PhamChinhCode/PID-G4-Master-Control/PID -Master-Control.kicad_pcb

## KiCad design PID -Master-Control.kicad_pcb (2026-11-12)

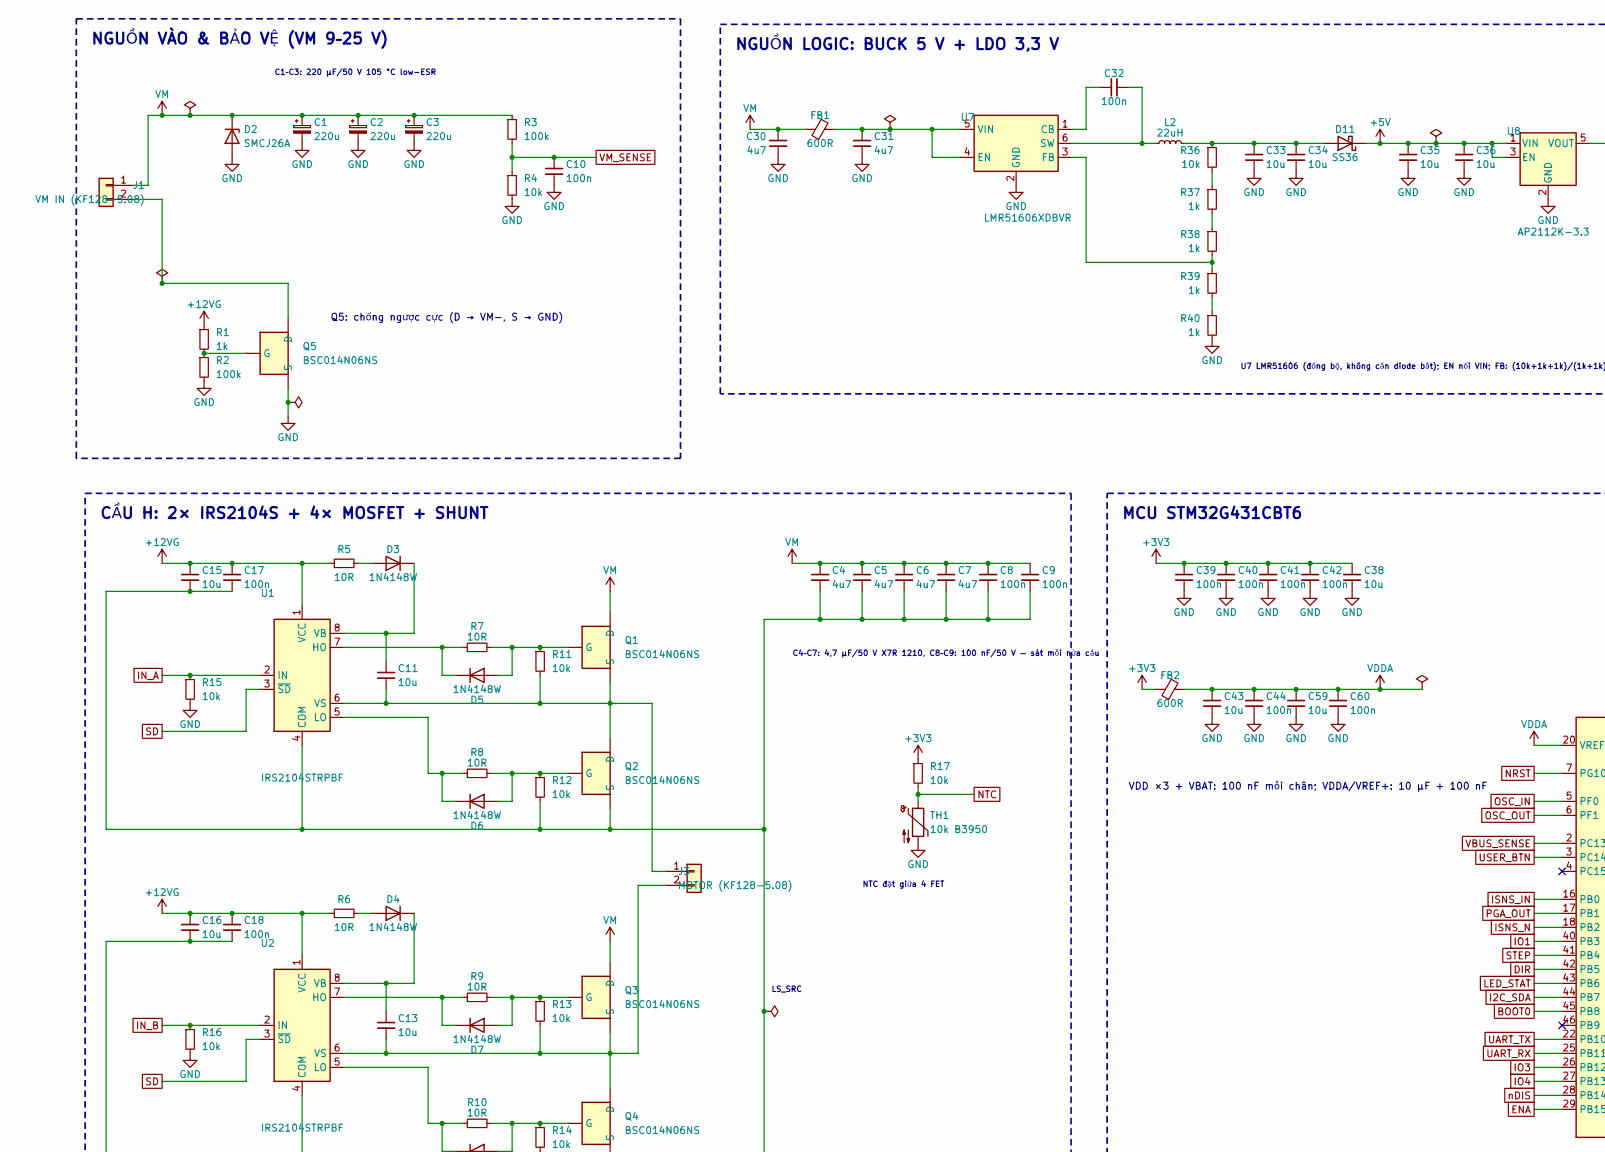
[picture p1: schematic PID -Master-Control.kicad_sch, G4_PID_Driver_V1, part in row 1, column 1]

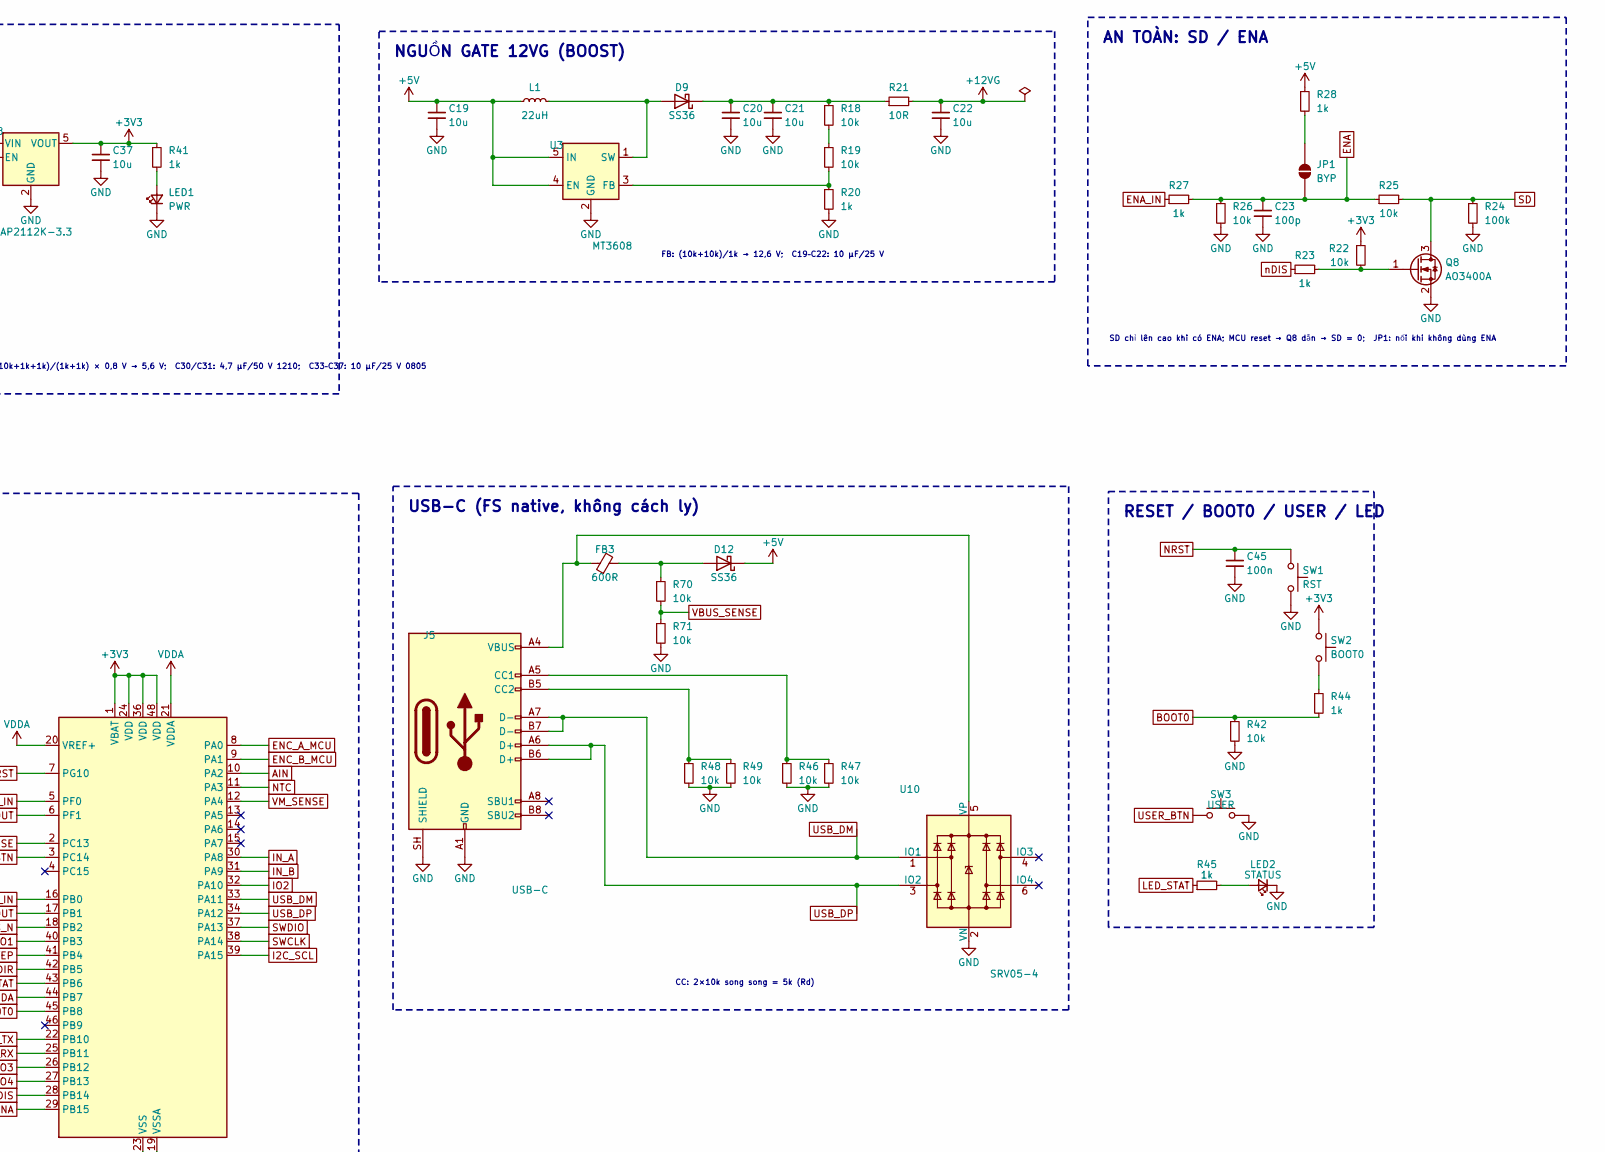
[picture p2: schematic PID -Master-Control.kicad_sch, G4_PID_Driver_V1, part in row 1, column 2]

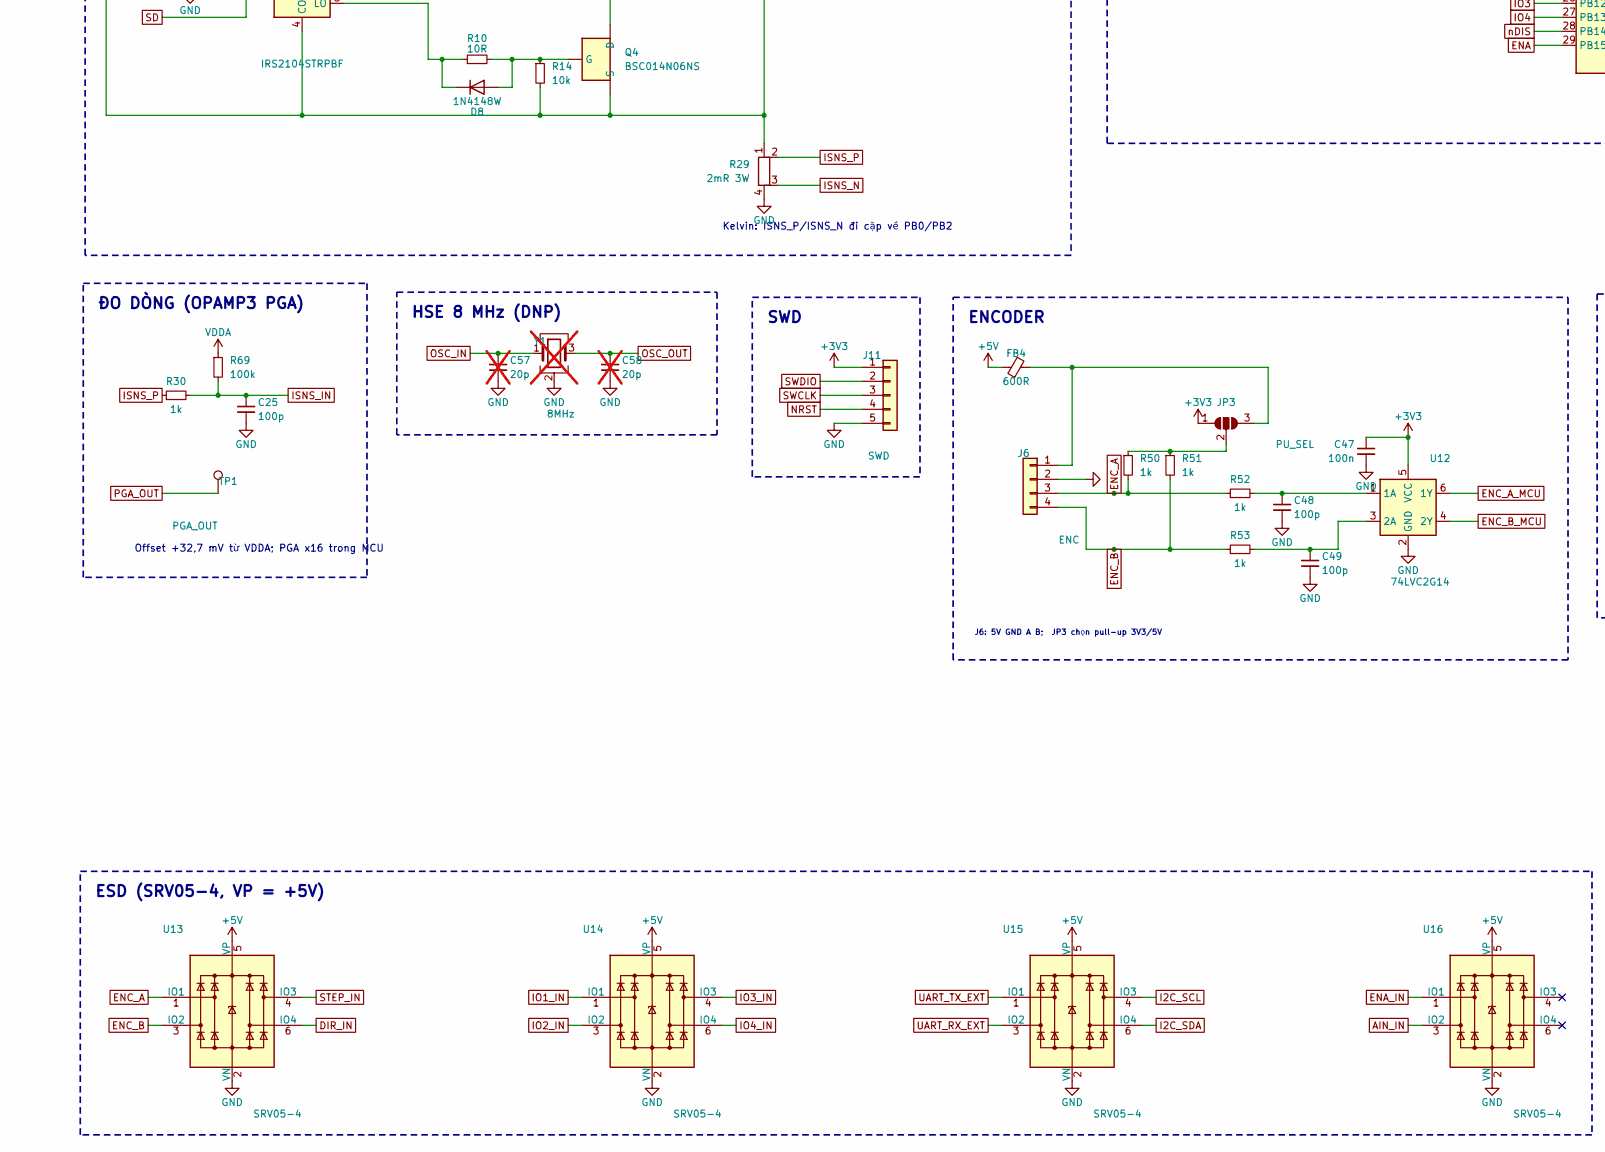
[picture p3: schematic PID -Master-Control.kicad_sch, G4_PID_Driver_V1, part in row 2, column 1]

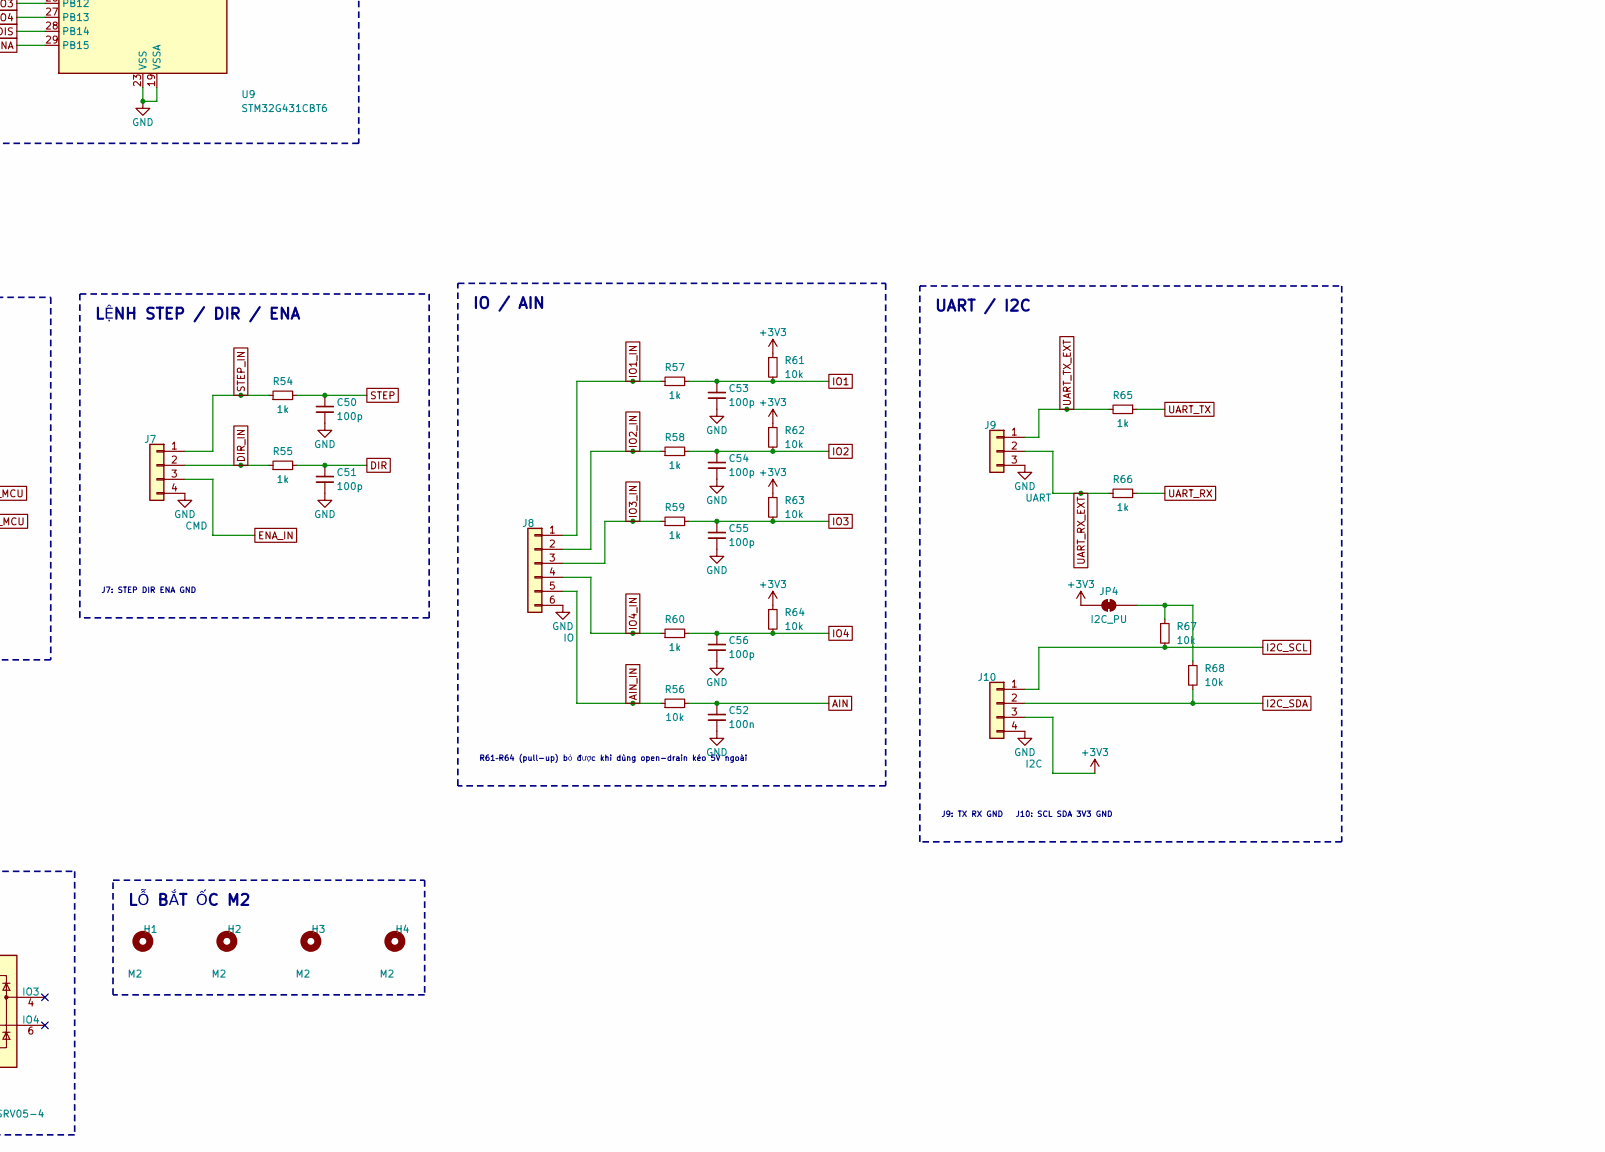
[picture p4: schematic PID -Master-Control.kicad_sch, G4_PID_Driver_V1, part in row 2, column 2]

Parts:
C1, C2, C3: 220u; CP_Elec_10x10.5
C4, C5, C6, C7, C30, C31: 4u7; C_1210_3225Metric
C8, C9, C10, C17, C18, C32, C39, C40, C41, C42, C44, C45, C47, C52, C60: 100n; C_0603_1608Metric
C11, C13, C15, C16, C19, C20, C21, C22, C33, C34, C35, C36, C37, C38, C43, C59: 10u; C_0805_2012Metric
C23, C25, C48, C49, C50, C51, C53, C54, C55, C56: 100p; C_0603_1608Metric
C57, C58: 20p; C_0603_1608Metric; not fitted
D2: SMCJ26A; D_SMC
D3, D4, D5, D6, D7, D8: 1N4148W; D_SOD-123
D9, D11, D12: SS36; D_SMA
FB1, FB2, FB3, FB4: 600R; L_0805_2012Metric
H1, H2, H3, H4: M2; MountingHole_2.2mm_M2
J1: VM IN (KF128-5.08); KF128-5.08-2P
J3: MOTOR (KF128-5.08); KF128-5.08-2P
J5: USB-C; USB_C_Receptacle_HRO_TYPE-C-31-M-12
J6: ENC; JST_XH_S4B-XH-A_1x04_P2.50mm_Horizontal
J7: CMD; JST_XH_S4B-XH-A_1x04_P2.50mm_Horizontal
J8: IO; JST_XH_S6B-XH-A_1x06_P2.50mm_Horizontal
J9: UART; JST_XH_S3B-XH-A_1x03_P2.50mm_Horizontal
J10: I2C; JST_XH_S4B-XH-A_1x04_P2.50mm_Horizontal
J11: SWD; JST_XH_S5B-XH-A_1x05_P2.50mm_Horizontal
JP1: BYP; SolderJumper-2_P1.3mm_Open_RoundedPad1.0x1.5mm
JP3: PU_SEL; SolderJumper-3_P1.3mm_Open_RoundedPad1.0x1.5mm_NumberLabels
JP4: I2C_PU; SolderJumper-2_P1.3mm_Bridged_RoundedPad1.0x1.5mm
L1, L2: 22uH; L_Bourns-SRN4018
LED1: PWR; LED_0603_1608Metric
LED2: STATUS; LED_0603_1608Metric
Q1, Q2, Q3, Q4, Q5: BSC014N06NS; TDSON-8-1
Q8: AO3400A; SOT-23
R1, R20, R23, R27, R28, R30, R37, R38, R39, R40, R41, R44, R45, R50, R51, R52, R53, R54, R55, R57, R58, R59, R60, R65, R66: 1k; R_0603_1608Metric
R2, R3, R24, R69: 100k; R_0603_1608Metric
R4, R11, R12, R13, R14, R15, R16, R17, R18, R19, R22, R25, R26, R36, R42, R46, R47, R48, R49, R56, R61, R62, R63, R64, R67, R68, R70, R71: 10k; R_0603_1608Metric
R5, R6, R7, R8, R9, R10, R21: 10R; R_0603_1608Metric
R29: 2mR 3W; R_Shunt_Vishay_WSK2512_6332Metric_T1.19mm
SW1: RST; SW_SPST_PTS810
SW2: BOOT0; SW_SPST_PTS810
SW3: USER; SW_SPST_PTS810
TH1: 10k B3950; R_0603_1608Metric
TP1: PGA_OUT; TestPoint_Pad_D1.5mm
U1, U2: IRS2104STRPBF; SOIC-8_3.9x4.9mm_P1.27mm
U3: MT3608; SOT-23-6
U7: LMR51606XDBVR; SOT-23-6
U8: AP2112K-3.3; SOT-23-5
U9: STM32G431CBT6; LQFP-48_7x7mm_P0.5mm
U10, U13, U14, U15, U16: SRV05-4; SOT-23-6
U12: 74LVC2G14; SOT-23-6
Y1: 8MHz; Crystal_SMD_3225-4Pin_3.2x2.5mm; not fitted

Connections:
+3V3: C37.1, C38.1, C39.1, C40.1, C41.1, C42.1, C47.1, FB2.1, J10.3, J11.1, JP3.1 (A), JP4.1 (A), R17.1, R22.1, R41.1, R61.1, R62.1, R63.1, R64.1, SW2.1, U8.5 (VOUT), U9.1 (VBAT), U9.24 (VDD), U9.36 (VDD), U9.48 (VDD), U12.5 (VCC)
+5V: C19.1, C35.1, C36.1, D11.1 (K), D12.1 (K), FB4.1, L1.1, R28.1, U3.4 (EN), U3.5 (IN), U8.1 (VIN), U8.3 (EN), U13.5 (VP), U14.5 (VP), U15.5 (VP), U16.5 (VP)
+12VG: C15.1, C16.1, C17.1, C18.1, C22.1, R1.1, R5.1, R6.1, R21.2, U1.1 (VCC), U2.1 (VCC)
AIN: C52.1, R56.2, U9.10 (PA2)
AIN_IN: J8.5, R56.1, U16.3 (IO2)
BOOT0: R42.1, R44.2, U9.45 (PB8)
DIR: C51.1, R55.2, U9.42 (PB5)
DIR_IN: J7.2, R55.1, U13.6 (IO4)
ENA: C23.1, JP1.2 (B), R25.1, R26.1, R27.2, U9.29 (PB15)
ENA_IN: J7.3, R27.1, U16.1 (IO1)
ENC_A: J6.3, R50.2, R52.1, U13.1 (IO1)
ENC_A_MCU: U9.8 (PA0), U12.6 (1Y)
ENC_B: J6.4, R51.2, R53.1, U13.3 (IO2)
ENC_B_MCU: U9.9 (PA1), U12.4 (2Y)
GND: C1.2, C2.2, C3.2, C10.2, C19.2, C20.2, C21.2, C22.2, C23.2, C25.2, C30.2, C31.2, C33.2, C34.2, C35.2, C36.2, C37.2, C38.2, C39.2, C40.2, C41.2, C42.2, C43.2, C44.2, C45.2, C47.2, C48.2, C49.2, C50.2, C51.2, C52.2, C53.2, C54.2, C55.2, C56.2, C57.2, C58.2, C59.2, C60.2, D2.2 (A), J5.A1 (GND), J5.A12 (GND), J5.B1 (GND), J5.B12 (GND), J5.SH (SHIELD), J6.2, J7.4, J8.6, J9.3, J10.4, J11.5, LED1.1 (K), LED2.1 (K), Q5.1 (S), Q5.2 (S), Q5.3 (S), Q8.2 (S), R2.2, R4.2, R15.2, R16.2, R20.2, R24.2, R26.2, R29.4, R40.2, R42.2, R46.2, R47.2, R48.2, R49.2, R71.2, SW1.2, SW3.2, TH1.2, U3.2 (GND), U7.2 (GND), U8.2 (GND), U9.19 (VSSA), U9.23 (VSS), U9.35 (VSS), U9.47 (VSS), U10.2 (VN), U12.2 (GND), U13.2 (VN), U14.2 (VN), U15.2 (VN), U16.2 (VN), Y1.2 (G), Y1.4 (G)
I2C_SCL: J10.1, R67.2, U9.39 (PA15), U15.4 (IO3)
I2C_SDA: J10.2, R68.2, U9.44 (PB7), U15.6 (IO4)
IN_A: R15.1, U1.2 (IN), U9.30 (PA8)
IN_B: R16.1, U2.2 (IN), U9.31 (PA9)
IO1: C53.1, R57.2, R61.2, U9.40 (PB3)
IO1_IN: J8.1, R57.1, U14.1 (IO1)
IO2: C54.1, R58.2, R62.2, U9.32 (PA10)
IO2_IN: J8.2, R58.1, U14.3 (IO2)
IO3: C55.1, R59.2, R63.2, U9.26 (PB12)
IO3_IN: J8.3, R59.1, U14.4 (IO3)
IO4: C56.1, R60.2, R64.2, U9.27 (PB13)
IO4_IN: J8.4, R60.1, U14.6 (IO4)
ISNS_IN: C25.1, R30.2, R69.2, U9.16 (PB0)
ISNS_N: R29.3, U9.18 (PB2)
ISNS_P: R29.2, R30.1
LED_STAT: R45.1, U9.43 (PB6)
NRST: C45.1, J11.4, SW1.1, U9.7 (PG10)
NTC: R17.2, TH1.1, U9.11 (PA3)
unnamed: D3.2 (A), R5.2
unnamed: C11.1, D3.1 (K), U1.8 (VB)
unnamed: D4.2 (A), R6.2
unnamed: C13.1, D4.1 (K), U2.8 (VB)
unnamed: D5.2 (A), Q1.4 (G), R7.2, R11.1
unnamed: D5.1 (K), R7.1, U1.7 (HO)
unnamed: D6.2 (A), Q2.4 (G), R8.2, R12.1
unnamed: D6.1 (K), R8.1, U1.5 (LO)
unnamed: D7.2 (A), Q3.4 (G), R9.2, R13.1
unnamed: D7.1 (K), R9.1, U2.7 (HO)
unnamed: D8.2 (A), Q4.4 (G), R10.2, R14.1
unnamed: D8.1 (K), R10.1, U2.5 (LO)
unnamed: D9.2 (A), L1.2, U3.1 (SW)
unnamed: C20.1, C21.1, D9.1 (K), R18.1, R21.1
unnamed: C33.1, C34.1, D11.2 (A), L2.2, R36.1
unnamed: D12.2 (A), FB3.2, R70.1
unnamed: J1.2, Q5.5 (D)
unnamed: C11.2, J3.1, Q1.1 (S), Q1.2 (S), Q1.3 (S), Q2.5 (D), R11.2, U1.6 (VS)
unnamed: C13.2, J3.2, Q3.1 (S), Q3.2 (S), Q3.3 (S), Q4.5 (D), R13.2, U2.6 (VS)
unnamed: J5.A5 (CC1), R46.1, R47.1
unnamed: J5.B5 (CC2), R48.1, R49.1
unnamed: FB4.2, J6.1, JP3.3 (B)
unnamed: JP1.1 (A), R28.2
unnamed: JP3.2 (C), R50.1, R51.1
unnamed: JP4.2 (B), R67.1, R68.1
unnamed: LED1.2 (A), R41.2
unnamed: LED2.2 (A), R45.2
unnamed: Q5.4 (G), R1.2, R2.1
unnamed: Q8.1 (G), R22.2, R23.2
unnamed: R18.2, R19.1
unnamed: R36.2, R37.1
unnamed: R37.2, R38.1
unnamed: R39.2, R40.1
unnamed: R44.1, SW2.2
unnamed: C4.2, C5.2, C6.2, C7.2, C8.2, C9.2, C15.2, C16.2, C17.2, C18.2, Q2.1 (S), Q2.2 (S), Q2.3 (S), Q4.1 (S), Q4.2 (S), Q4.3 (S), R12.2, R14.2, R29.1, U1.4 (COM), U2.4 (COM)
unnamed: R19.2, R20.1, U3.3 (FB)
unnamed: C32.1, U7.1 (CB)
unnamed: C31.1, FB1.2, U7.4 (EN), U7.5 (VIN)
unnamed: R38.2, R39.1, U7.3 (FB)
unnamed: C32.2, L2.1, U7.6 (SW)
unnamed: FB3.1, J5.A4 (VBUS), J5.A9 (VBUS), J5.B4 (VBUS), J5.B9 (VBUS), U10.5 (VP)
unnamed: C48.1, R52.2, U12.1 (1A)
unnamed: C49.1, R53.2, U12.3 (2A)
OSC_IN: C57.1, U9.5 (PF0), Y1.1
OSC_OUT: C58.1, U9.6 (PF1), Y1.3
PGA_OUT: TP1.1, U9.17 (PB1)
SD: Q8.3 (D), R24.1, R25.2, U1.3 (~SD), U2.3 (~SD)
STEP: C50.1, R54.2, U9.41 (PB4)
STEP_IN: J7.1, R54.1, U13.4 (IO3)
SWCLK: J11.3, U9.38 (PA14)
SWDIO: J11.2, U9.37 (PA13)
UART_RX: R66.2, U9.25 (PB11)
UART_RX_EXT: J9.2, R66.1, U15.3 (IO2)
UART_TX: R65.1, U9.22 (PB10)
UART_TX_EXT: J9.1, R65.2, U15.1 (IO1)
USB_DM: J5.A7 (D-), J5.B7 (D-), U9.33 (PA11), U10.1 (IO1)
USB_DP: J5.A6 (D+), J5.B6 (D+), U9.34 (PA12), U10.3 (IO2)
USER_BTN: SW3.1, U9.3 (PC14)
VBUS_SENSE: R70.2, R71.1, U9.2 (PC13)
VDDA: C43.1, C44.1, C59.1, C60.1, FB2.2, R69.1, U9.20 (VREF+), U9.21 (VDDA)
VM: C1.1, C2.1, C3.1, C4.1, C5.1, C6.1, C7.1, C8.1, C9.1, C30.1, D2.1 (K), FB1.1, J1.1, Q1.5 (D), Q3.5 (D), R3.1
VM_SENSE: C10.1, R3.2, R4.1, U9.12 (PA4)
nDIS: R23.1, U9.28 (PB14)

Notes on the sheet:
VDD ×3 + VBAT: 100 nF mỗi chân; VDDA/VREF+: 10 µF + 100 nF
NGUỒN VÀO & BẢO VỆ (VM 9–25 V)
C4–C7: 4,7 µF/50 V X7R 1210, C8–C9: 100 nF/50 V — sát mỗi nửa cầu
IO / AIN
U7 LMR51606 (đồng bộ, không cần diode bắt); EN nối VIN; FB: (10k+1k+1k)/(1k+1k) × 0,8 V → 5,6 V; C30/C31: 4,7 µF/50 V 1210; C33–C37: 10 µF/25 V 0805
J6: 5V GND A B; JP3 chọn pull-up 3V3/5V
SD chỉ lên cao khi có ENA; MCU reset → Q8 dẫn → SD = 0; JP1: nối khi không dùng ENA
SWD
CC: 2×10k song song = 5k (Rd)
ENCODER
AN TOÀN: SD / ENA
UART / I2C
Q5: chống ngược cực (D → VM−, S → GND)
NGUỒN LOGIC: BUCK 5 V + LDO 3,3 V
HSE 8 MHz (DNP)
FB: (10k+10k)/1k → 12,6 V; C19–C22: 10 µF/25 V
NGUỒN GATE 12VG (BOOST)
Offset +32,7 mV từ VDDA; PGA x16 trong MCU
MCU STM32G431CBT6
RESET / BOOT0 / USER / LED
J9: TX RX GND J10: SCL SDA 3V3 GND
NTC đặt giữa 4 FET
LỆNH STEP / DIR / ENA
C1–C3: 220 µF/50 V 105 °C low-ESR
LS_SRC
Kelvin: ISNS_P/ISNS_N đi cặp về PB0/PB2
ĐO DÒNG (OPAMP3 PGA)
ESD (SRV05-4, VP = +5V)
R61–R64 (pull-up) bỏ được khi dùng open-drain kéo 5V ngoài
J7: STEP DIR ENA GND
LỖ BẮT ỐC M2
USB-C (FS native, không cách ly)
CẦU H: 2× IRS2104S + 4× MOSFET + SHUNT

Board: 4 copper layers, 175 parts (0 on the bottom side), 96 nets, no tracks yet.
