PhamChinhCode/PID-G4-Master-Control/(commit log)

2026-11-10 Initial commit: KiCad project PID Master Control
    [PID -Master-Control.kicad_pcb, PID -Master-Control.kicad_sch]
2026-11-10 Add G4_PID_Driver_V1 design doc (STM32G431)
    Design for a single-motor encoder driver based on F1_PID_Driver_V2,
    keeping its power stage and SD/ENA safety circuit and moving the MCU
    to STM32G431CBT6:
    - native USB (CDC + ROM DFU), drops CH340C
    - current sense via internal OPAMP3 PGA x16 with Kelvin reference
    - cycle-by-cycle current limit via COMP1 + DAC3 into TIM1 break
    - no FDCAN; PB8 stays BOOT0 with a button; HSI16/HSI48, crystal DNP
    - BOM 33 -> 29 part codes; pin map still to be verified in CubeMX
2026-11-10 Single-sheet schematic, project symbol lib, BOM consolidation, part swaps
    - Merge schematic into one A2 sheet with 17 framed blocks: wires inside a
    block, global labels between blocks; ERC 0 errors / 0 warnings
    - Add project symbol library PID_G4 (NMOS_PDFN5x6, LMR51606, 74LVC2G14_SU)
    - Drop 1 uF code: use 10 uF 0805 (bootstrap 1x per half-bridge)
    - Buck: MP2459 -> TI LMR51606XDBVR (65 V, synchronous); drop D10, R74
    - MOSFETs: BSC014N06NS; gate drivers: IRS2104STRPBF (VIH 2.5 V)
    - Update design doc BOM: 28 part codes, ~156 parts
    - Add KiCad design guide; ignore KiCad .history/
    [PID -Master-Control.kicad_sch]
2026-11-11 update sch and pcb
    [PID -Master-Control.kicad_pcb, PID -Master-Control.kicad_sch]
